rguisantos/pixgate/hardware/pixgate.kicad_pcb

## KiCad design hardware/pixgate.kicad_pcb (2026-11-12)

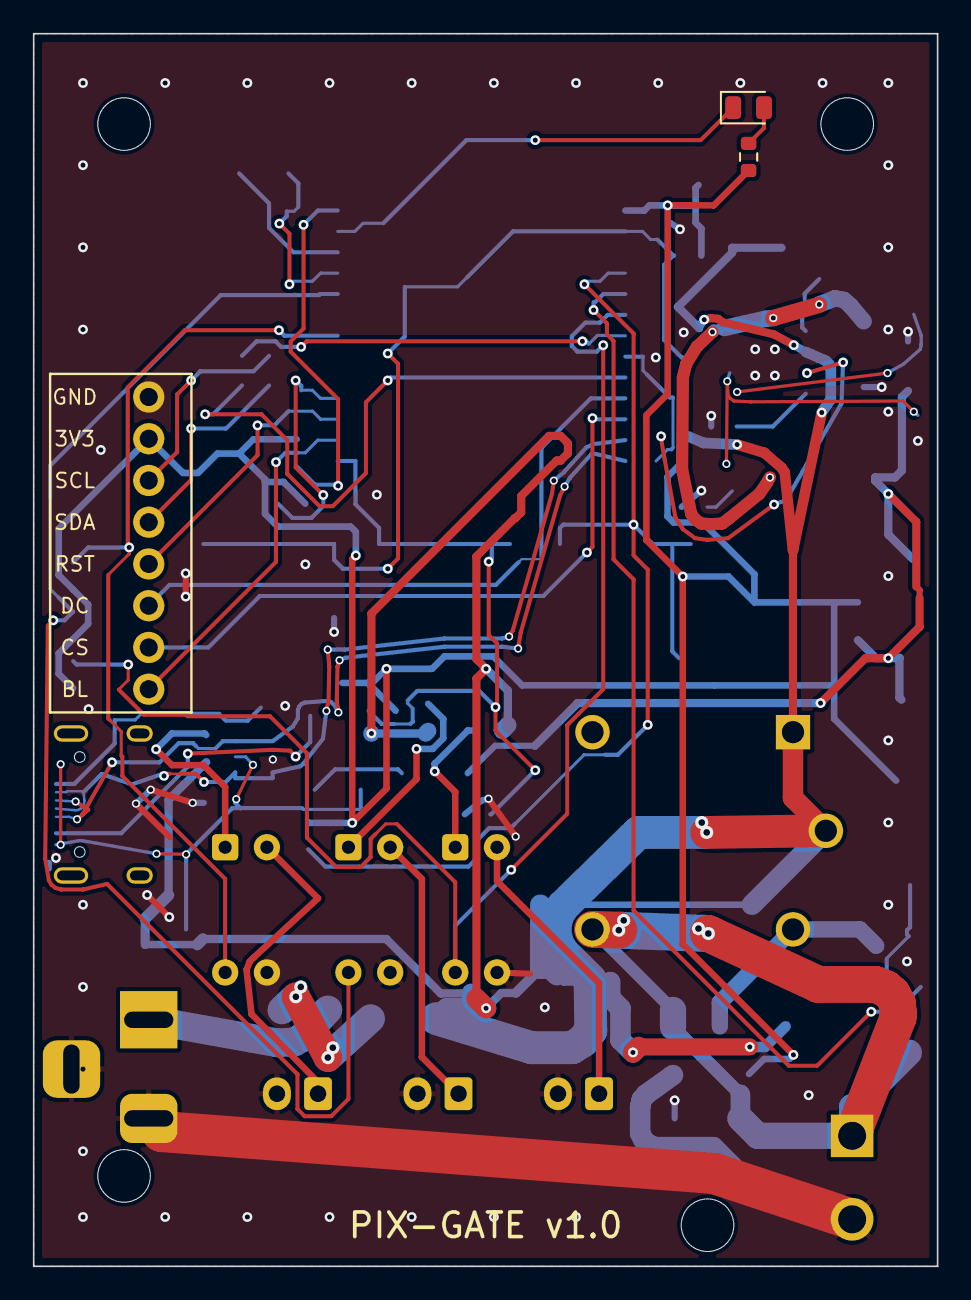
[picture p1: board pixgate.kicad_pcb from above]

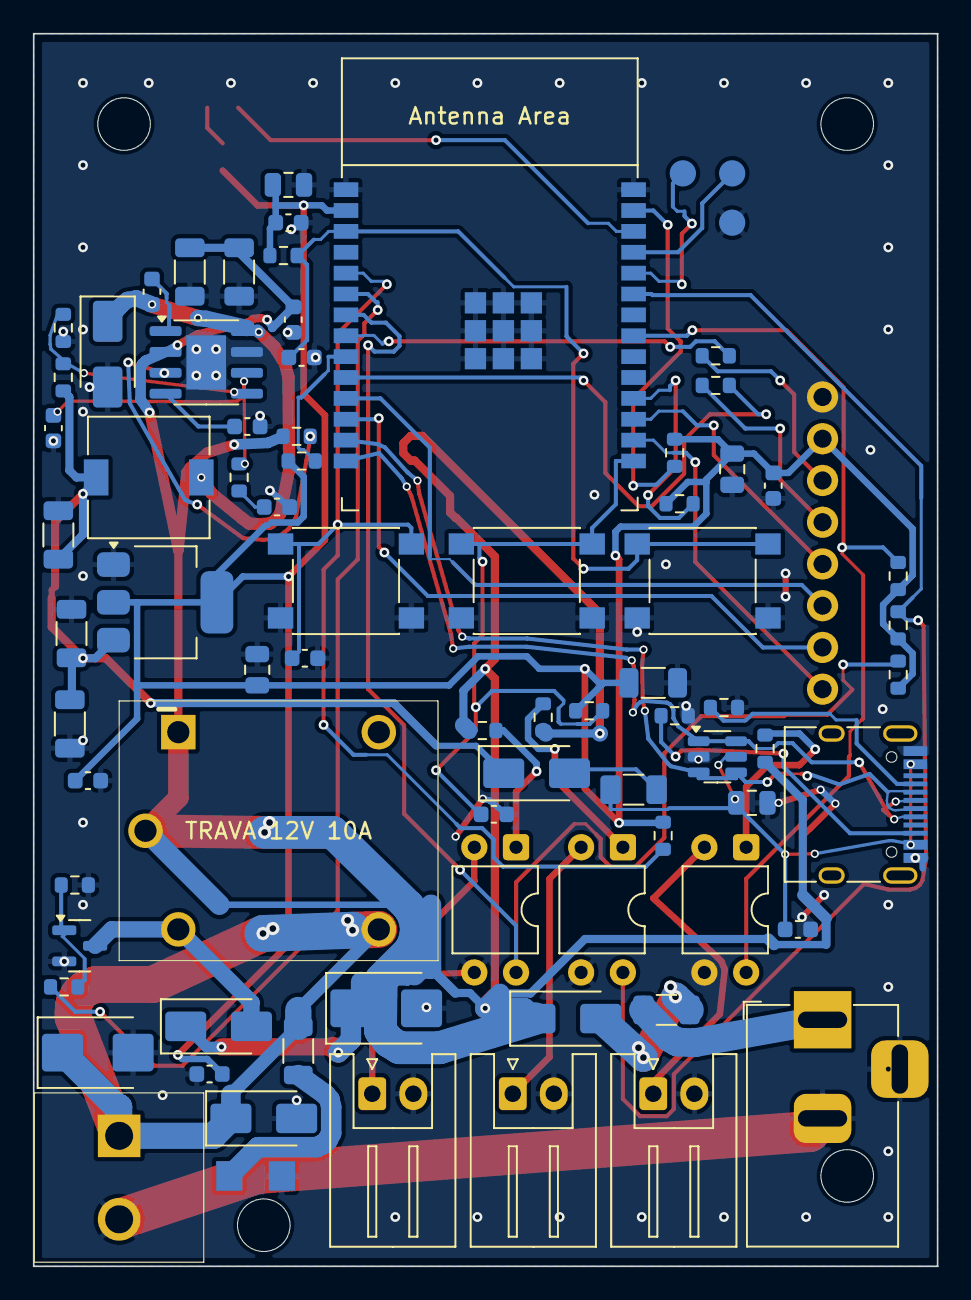
[picture p2: board pixgate.kicad_pcb from below]

Board: 2 copper layers, 55.0 x 75.0 mm, 85 parts (82 on the bottom side), 51 nets.

Parts:
C1, C2: 10uF/25V; C_1206_3216Metric
C3, C4, C9, C13, C15, C17, C19, C20, C21, C22: 100nF; C_0603_1608Metric
C5, C6: 33uF/10V; C_1206_3216Metric
C7: 4.7nF; C_0603_1608Metric
C8: 39pF; C_0603_1608Metric
C10, C12: 22uF; C_1206_3216Metric
C11, C14, C16, C18: 10uF; C_0805_2012Metric
C23: 1uF; C_0603_1608Metric
C24: 100nF; C_1206_3216Metric_NoSilk
D1, D5: SS54; D_SMA
D2, D3: SS14; D_SMA
D4: SMBJ18A; D_SMB
D6: SMBJ16A; D_SMB
D7: M7; D_SMA
F1, F2: 1206L050/24; Fuse_1206_3216Metric
H1, H2, H3, H4: M3; MountingHole_3.2mm_M3
J1: DC-005 12V; BarrelJack_Horizontal
J2: KF301 TRAVA; TerminalBlock_KF301-2P-5.08mm
J3: JST-XH NOTEIRO; JST_XH_S2B-XH-A_1x02_P2.50mm_Horizontal
J4: JST-XH MOEDEIRO; JST_XH_S2B-XH-A_1x02_P2.50mm_Horizontal
J5: JST-XH BOTAO; JST_XH_S2B-XH-A_1x02_P2.50mm_Horizontal
J6: USB-C; USB_C_Receptacle_HRO_TYPE-C-31-M-12
J7: TFT 1.54; DisplaySocket_1x08_P2.54mm
K1: SRD-12VDC-SL-C; Relay_SPDT_Songle_SRD
L1: 6.8uH; L_7.3x7.3_H3.5
LED1: STATUS; LED_0805_2012Metric
OPT1, OPT2, OPT3: PC817; DIP-4_W7.62mm
Q1: AO3400A; SOT-23
R1, R2: 5.1k; R_0603_1608Metric
R3: 100R; R_0603_1608Metric
R4, R7, R8, R9, R10, R11, R12, R13, R14, R15, R20: 10k; R_0603_1608Metric
R5, R6: 33R; R_0603_1608Metric
R16, R17, R18: 2.2k; R_0603_1608Metric
R19: 1k; R_0603_1608Metric
R21: 1.91k; R_0603_1608Metric
R22: 49.9k; R_0603_1608Metric
R23: 100R; R_1206_3216Metric
R26: 100k; R_0603_1608Metric
SW1: RST; SW_SPST_PTS645
SW2: BOOT; SW_SPST_PTS645
SW3: CFG; SW_SPST_PTS645
TP1: TX0; TestPad_TX0
TP2: RX0; TestPad_RX0
TP3: GND; TestPad_GND
U1: ESP32-C5-WROOM-1-N8; ESP32-C5-WROOM-1
U2: TPS54331DDA; SOIC-8-1EP_3.9x4.9mm_P1.27mm_EP2.41x3.3mm
U3: AMS1117-3.3; SOT-223-3_TabPin2
U4: USBLC6-2SC6; SOT-23-6

Connections:
+3V3: C11.2, C12.2, C13.1, C14.1, C15.1, C18.1, C19.1, C23.1, J7.2, R7.1, R8.1, R9.1, R10.1, R11.1, R12.1, R13.2, R14.2, R15.2, R19.1, U1.2, U3.2
+5V: C5.2, C6.2, C10.1, D2.1, L1.2, R20.2, U3.3
+12V: C1.1, C2.1, C3.1, D1.1, D3.1, D4.1, K1.A1, K1.COM, R16.2, R17.2, R18.2, R26.1, U2.2
+12V_IN: F1.1, J1.1
BOOT_C: C4.1, U2.1
BTN1: C21.1, R8.2, SW2.1, U1.15
BTN2: C22.1, R9.2, SW3.1, U1.5
BTN_A: OPT3.1, R18.1
BTN_SIG: J5.1, OPT3.2
CC1: J6.A5, R1.1
CC2: J6.B5, R2.1
COIN_A: OPT2.1, R17.1
COIN_SIG: J4.1, OPT2.2
COMP_X: C8.1, R22.1, U2.6
COMP_Y: C7.1, R22.2
DISP_BL: J7.8, U1.16
DISP_CS: J7.7, U1.12
DISP_DC: J7.6, U1.11
DISP_RST: J7.5, U1.17
EN: C20.1, R7.2, SW1.1, U1.3
EN_BK: R26.2, U2.3
F12V: D1.2, F1.2
FB: R20.1, R21.1, U2.5
GND: C1.2, C2.2, C3.2, C5.1, C6.1, C7.2, C8.2, C9.2, C10.2, C11.1, C12.1, C13.2, C14.2, C15.2, C16.2, C17.2, C18.2, C19.2, C20.2, C21.2, C22.2, C23.2, C24.2, D4.2, D5.2, D6.2, D7.2, J1.2, J1.3, J2.2, J3.2, J4.2, J5.2, J6.A1, J6.A12, J6.B1, J6.B12, J7.1, OPT1.3, OPT2.3, OPT3.3, Q1.2, R1.2, R2.2, R4.2, R21.2, SW1.2, SW2.2, SW3.2, TP3.1, U1.1, U1.28, U1.29, U2.7, U2.9, U3.1, U4.2
IN_BTN: OPT3.4, R15.1, U1.7
IN_COIN: OPT2.4, R14.1, U1.23
IN_NOTE: OPT1.4, R13.1, U1.21
IO7_PU: R10.2, U1.9
IO26_PU: R11.2, U1.27
IO27_PU: R12.2, U1.18
LED_A: LED1.2, R19.2
LED_K: LED1.1, U1.26
MOSI_D: J7.4, R6.1
MOSI_M: R6.2, U1.10
NOTE_A: OPT1.1, R16.1
NOTE_SIG: J3.1, OPT1.2
RELAY_COIL: D3.2, K1.A2, Q1.3
RLY_DRV: R3.1, U1.6
RLY_GATE: Q1.1, R3.2, R4.1
RX0: TP2.1, U1.24
SCK_D: J7.3, R5.1
SCK_M: R5.2, U1.8
SS_C: C9.1, U2.4
SW: C4.2, D5.1, L1.1, U2.8
TRAVA_NO: D6.1, D7.1, J2.1, K1.NO, R23.1
TRAVA_NO2: C24.1, R23.2
TX0: TP1.1, U1.25
USB_5V_F: D2.2, F2.2
USB_DN: J6.A7, J6.B7, U1.13, U4.3, U4.4
USB_DP: J6.A6, J6.B6, U1.14, U4.1, U4.6
USB_VBUS: C16.1, C17.1, F2.1, J6.A4, J6.A9, J6.B4, J6.B9, U4.5
