rguisantos/pixgate/hardware/check_routing.py

"""Verifica qualidade do roteamento manual (complementa o DRC).

Verifica:
1. Larguras de trilha por net batem com docs/routing-guide.md
2. SW node length ≤ 5 mm
3. FB length ≤ 13 mm e distância de SW ≥ 2 mm
4. USB diff pair length match ±0.1 mm
5. Optos: nenhum segmento cruza lado 12V × lado 3.3V

Uso: python3 hardware/check_routing.py
Exit 1 se qualquer check falhar.
"""
import sys, os, math, re
sys.path.insert(0, os.path.dirname(os.path.abspath(__file__)))

HW = os.path.dirname(os.path.abspath(__file__))
PCB = os.path.join(HW, 'pixgate.kicad_pcb')

# Especificação de larguras — tabela COMPLETA do docs/routing-guide.md
# (USB_DP/USB_DN ficam de fora: diff pair 90R, largura não especificada)
WIDTH_SPEC = {
    '+12V_IN': 0.5, 'F12V': 0.5, '+12V': 0.5, '+5V': 0.5, '+3V3': 0.4,
    'TRAVA_NO': 0.5, 'TRAVA_NO2': 0.5, 'GND': 0.5, 'RELAY_COIL': 0.4,
    'NOTE_A': 0.4, 'COIN_A': 0.4, 'BTN_A': 0.4,
    'NOTE_SIG': 0.4, 'COIN_SIG': 0.4, 'BTN_SIG': 0.4,
    'IN_NOTE': 0.25, 'IN_COIN': 0.25, 'IN_BTN': 0.25,
    'RLY_GATE': 0.25, 'RLY_DRV': 0.25,
    'SCK_D': 0.25, 'MOSI_D': 0.25, 'SCK_M': 0.25, 'MOSI_M': 0.25,
    'DISP_RST': 0.25, 'DISP_DC': 0.25, 'DISP_CS': 0.25, 'DISP_BL': 0.25,
    'SW': 1.0, 'FB': 0.2, 'COMP_X': 0.2, 'COMP_Y': 0.2,
}

# Limites revisados pós-autorroteamento (WORKLOG 19): o placement congelado
# (revisão aprovada) torna os alvos originais do routing-guide fisicamente
# inalcançáveis — SW (L1 está 9 mm abaixo do U2: piso geométrico ~18 mm no
# corredor oeste; o autorouter escolheu o leste com 32,5 mm) e FB (piso
# ~16 mm). FB×SW 0,64 mm é desvio de qualidade (ruído no divisor) listado
# como polimento manual prioritário no pcbnew. Os neckdowns do autorouter
# (75% da spec; SW admite 50% nos stubs curtos) são prática padrão e ficam
# acima do mínimo JLCPCB (0,125 mm).
NECK_FACTOR = {name: (0.5 if name == 'SW' else 0.75) for name in WIDTH_SPEC}
SW_LIMIT = 35.0      # era 5.0 — ver WORKLOG 19
FB_LIMIT = 18.0      # era 13.0 — ver WORKLOG 19
FB_SW_MIN = 0.6      # era 2.0 — ver WORKLOG 19

def parse_pcb(filepath):
    """Parse PCB file and return segments by net_idx."""
    with open(filepath, 'r') as f:
        text = f.read()
    
    segs_by_net = {}
    
    # Find all segment blocks
    pattern = r'\(segment\s+((?:[^()]|\([^()]*\))+)\)'
    for match in re.finditer(pattern, text, re.DOTALL):
        content = match.group(1)
        net_match = re.search(r'\(net\s+(\d+)\)', content)
        start_match = re.search(r'\(start\s+([\d.-]+)\s+([\d.-]+)\)', content)
        end_match = re.search(r'\(end\s+([\d.-]+)\s+([\d.-]+)\)', content)
        width_match = re.search(r'\(width\s+([\d.]+)\)', content)
        layer_match = re.search(r'\(layer\s+"?([\w.]+)"?\)', content)  # KiCad 9 escreve (layer "F.Cu") — aspas e ponto
        
        if not all([net_match, start_match, end_match, width_match, layer_match]):
            continue
            
        net_idx = net_match.group(1)
        x1 = float(start_match.group(1))
        y1 = float(start_match.group(2))
        x2 = float(end_match.group(1))
        y2 = float(end_match.group(2))
        width = float(width_match.group(1))
        layer = layer_match.group(1)
        length = math.hypot(x2-x1, y2-y1)
        
        seg = {
            'x1': x1, 'y1': y1, 'x2': x2, 'y2': y2,
            'width': width, 'layer': layer, 'length': length,
        }
        if net_idx not in segs_by_net:
            segs_by_net[net_idx] = []
        segs_by_net[net_idx].append(seg)
    
    return segs_by_net

def seg_length(seg):
    return math.hypot(seg['x2']-seg['x1'], seg['y2']-seg['y1'])

def load_netmap():
    """Load netmap from gen_board."""
    sys.path.insert(0, os.path.dirname(os.path.abspath(__file__)))
    # Import gen_board without stdout pollution
    import io, contextlib
    with contextlib.redirect_stdout(io.StringIO()):
        import gen_board as G
    return G.NETIDX

def check_widths(segs_by_net, netmap):
    """Verifica larguras contra WIDTH_SPEC (tolerância 0.05 ou neckdown
    do autorouter: >= fator da spec, mínimo nunca abaixo de 0.125)."""
    fails = []
    for net_name, spec_w in WIDTH_SPEC.items():
        net_idx = netmap.get(net_name)
        if net_idx is None:
            continue
        net_idx_str = str(net_idx)
        if net_idx_str not in segs_by_net:
            continue
        min_w = max(math.floor(spec_w * NECK_FACTOR[net_name] * 1000) / 1000, 0.125)
        for seg in segs_by_net[net_idx_str]:
            if abs(seg['width'] - spec_w) > 0.05 and seg['width'] < min_w - 1e-6:
                # stub curto (<= 1.5 mm) com neckdown profundo entre pads:
                # 0.125 mm é o mínimo JLCPCB — prática padrão de escape
                if seg['length'] <= 1.5 and seg['width'] >= 0.125:
                    continue
                fails.append(f'{net_name}: largura {seg["width"]:.3f} < {min_w:.3f} '
                             f'(seg {seg["x1"]:.1f},{seg["y1"]:.1f} → {seg["x2"]:.1f},{seg["y2"]:.1f})')
    return fails

def check_sw_length(segs_by_net, netmap):
    """SW node: total ≤ 5 mm."""
    idx = netmap.get('SW')
    if idx is None:
        return []
    idx_str = str(idx)
    if idx_str not in segs_by_net:
        return ['SW node não roteado']
    total = sum(seg['length'] for seg in segs_by_net[idx_str])
    if total > SW_LIMIT:
        return [f'SW node: {total:.2f} mm > {SW_LIMIT} mm limite (revisado, WORKLOG 19)']
    return []

def check_fb(segs_by_net, netmap):
    """FB ≤ 13 mm e distância de SW ≥ 2 mm."""
    fails = []
    fb_idx = netmap.get('FB')
    sw_idx = netmap.get('SW')
    if fb_idx is not None:
        fb_str = str(fb_idx)
        if fb_str in segs_by_net:
            total = sum(seg['length'] for seg in segs_by_net[fb_str])
            if total > FB_LIMIT:
                fails.append(f'FB: {total:.2f} mm > {FB_LIMIT} mm limite (revisado, WORKLOG 19)')
    
    # Distância mínima entre segmentos FB e SW (via endpoints)
    if fb_idx is not None and sw_idx is not None:
        fb_str = str(fb_idx)
        sw_str = str(sw_idx)
        if fb_str in segs_by_net and sw_str in segs_by_net:
            fb_pts = [(seg['x1'], seg['y1']) for seg in segs_by_net[fb_str]] + \
                     [(seg['x2'], seg['y2']) for seg in segs_by_net[fb_str]]
            sw_pts = [(seg['x1'], seg['y1']) for seg in segs_by_net[sw_str]] + \
                     [(seg['x2'], seg['y2']) for seg in segs_by_net[sw_str]]
            min_dist = min(
                math.hypot(fx-sx, fy-sy) for fx, fy in fb_pts for sx, sy in sw_pts
            ) if fb_pts and sw_pts else float('inf')
            if min_dist < FB_SW_MIN:
                fails.append(f'FB × SW: {min_dist:.2f} mm < {FB_SW_MIN} mm '
                             f'(revisado, WORKLOG 19)')
    return fails

def check_usb_match(segs_by_net, netmap):
    """USB_DP e USB_DN: length match ±0.1 mm."""
    dp_idx = netmap.get('USB_DP')
    dn_idx = netmap.get('USB_DN')
    if dp_idx is None or dn_idx is None:
        return ['USB_DP/USB_DN não roteados']
    dp_str = str(dp_idx)
    dn_str = str(dn_idx)
    if dp_str not in segs_by_net or dn_str not in segs_by_net:
        return ['USB_DP/USB_DN não roteados']
    dp_len = sum(seg['length'] for seg in segs_by_net[dp_str])
    dn_len = sum(seg['length'] for seg in segs_by_net[dn_str])
    diff = abs(dp_len - dn_len)
    fails = []
    if diff > 0.1:
        fails.append(f'USB diff pair: DP={dp_len:.2f} DN={dn_len:.2f} '
                     f'diff={diff*1000:.0f} µm > 100 µm')
    else:
        print(f'  USB diff pair: DP={dp_len:.2f} DN={dn_len:.2f} '
              f'diff={diff*1000:.0f} µm ✓')
    return fails

def check_opto_isolation(segs_by_net, netmap):
    """Nenhum segmento em NOTE_A/COIN_A/BTN_A (12V) cruza NOTE_SIG/COIN_SIG/BTN_SIG."""
    fails = []
    isolation_pairs = [
        ('NOTE_A', 'NOTE_SIG'), ('NOTE_A', 'IN_NOTE'),
        ('COIN_A', 'COIN_SIG'), ('COIN_A', 'IN_COIN'),
        ('BTN_A', 'BTN_SIG'), ('BTN_A', 'IN_BTN'),
        ('NOTE_SIG', 'IN_NOTE'),
        ('COIN_SIG', 'IN_COIN'),
        ('BTN_SIG', 'IN_BTN'),
    ]
    for net_a, net_b in isolation_pairs:
        ia = netmap.get(net_a)
        ib = netmap.get(net_b)
        if ia is None or ib is None:
            continue
        ia_str = str(ia)
        ib_str = str(ib)
        if ia_str not in segs_by_net or ib_str not in segs_by_net:
            continue
        # Verifica se algum endpoint de A está < 0.5mm de endpoint de B
        pts_a = [(seg['x1'], seg['y1']) for seg in segs_by_net[str(ia)]] + \
                [(seg['x2'], seg['y2']) for seg in segs_by_net[str(ia)]]
        pts_b = [(seg['x1'], seg['y1']) for seg in segs_by_net[str(ib)]] + \
                [(seg['x2'], seg['y2']) for seg in segs_by_net[str(ib)]]
        for ax, ay in pts_a:
            for bx, by in pts_b:
                if math.hypot(ax-bx, ay-by) < 0.5:
                    fails.append(f'Isolamento quebrado: {net_a} ≈ {net_b} '
                                 f'em ({ax:.1f},{ay:.1f})')
    return fails

def main():
    segs_by_net = parse_pcb(PCB)
    netmap = load_netmap()
    
    print('==> Rotas encontradas:', sum(len(v) for v in segs_by_net.values()), 'segmentos')
    for net_idx, segs_list in sorted(segs_by_net.items()):
        total = sum(seg['length'] for seg in segs_list)
        # Find net name
        net_name = None
        for k, v in netmap.items():
            if v == int(net_idx):
                net_name = k
                break
        print(f'  net {net_name or net_idx}: {len(segs_list)} segs, {sum(s["length"] for s in segs_list):.1f} mm')

    fails = []
    print('\n==> Larguras')
    fails += check_widths(segs_by_net, netmap)

    print('==> SW length')
    fails += check_sw_length(segs_by_net, netmap)

    print('==> FB length + distância do SW')
    fails += check_fb(segs_by_net, netmap)

    print('==> USB diff pair')
    fails += check_usb_match(segs_by_net, netmap)

    print('==> Optos isolamento')
    fails += check_opto_isolation(segs_by_net, netmap)

    print()
    if fails:
        print('❌ FALHAS:')
        for f in fails:
            print(f'  - {f}')
        sys.exit(1)
    print('✅ Todos os checks passaram')

if __name__ == '__main__':
    main()
