rguisantos/pixgate/(commit log)

2026-11-09 PixGate v1.0 (WIP): gerador programático da placa em Python para KiCad 9
    - hardware/gen_board.py: netlist completa (51 redes) e colocação de 85 itens
    (ESP32-C5-WROOM-1, buck TPS54331, AMS1117, 3x PC817, relé SRD-12VDC,
    USB-C com USBLC6, TFT 1.54 frontal, proteções) + footprints custom
    - hardware/pcb_lib.py: parser/serializador S-expression, flip de footprint
    para o verso (pads/graphics/textos/zonas), embed com nets, builders
    - validation/: boards de teste e relatórios DRC (kicad-cli) com a trilha de
    validação de formato, bisection de outline, semântica de flip e rotação
    - tools/: shim LD_PRELOAD para kicad-cli com libs externas + parsers de
    pesquisa (land pattern SVG, p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
    [test.kicad_pcb, test2.kicad_pcb, test3.kicad_pcb, test4.kicad_pcb, test_min.kicad_pcb]
2026-11-09 worklog: registra sessão de publicação e sanity check do gerador
2026-11-09 Serializacao do board completo + correcao do bug de rotacao de pads (KiCad 9)
    DESCOBERTA CRITICA (validada por experimento com a API pcbnew): no formato
    .kicad_pcb do KiCad 9, o at.rot do footprint move apenas as POSICOES dos
    itens; o shape de cada pad gira pela rotacao do at do PROPRIO pad, que deve
    carregar a rotacao total. O gerador omitia essa rotacao -> shapes nao
    girados -> ~90 violacoes falsas por footprint rotacionado (incluindo shorts
    GND<->VBUS inexistentes no USB-C).
    - pcb_lib: apply_pad_rotation() no placement; textos no verso com (justify
    mirror); embed_footprint e set_fp_texts idempotentes
    - footprints legados (refs/kfp @2020, formato module/fp_arc) trocados pelos
    9.0.2 do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
    [pixgate.kicad_pcb]
2026-11-09 housekeeping: bits de executavel nos scripts do repo
    [pixgate.kicad_pcb]
2026-11-09 layout: elimina os 4 shorts de colocacao (D4, D6, C20, R12)
    - D4 x+0.35, D6 x+0.25, C20 y+0.3, R12 -> (40.7, 53.6)
    - place_check: D1<->D4 e SW2<->R12 zerados; D3<->D6 e C3<->C20 em 0.200mm
    - DRC KiCad 9: 0 shorting_items, 0 solder_mask_bridge (total 217->211)
    - novo: borda direita do D6 (copper_edge 0.25mm) documentada no WORKLOG
    [pixgate.kicad_pcb]
2026-11-09 layout: resolve efeito colateral do D6 afastando o D3
    - D6 reverte ao original (76.1, 87): cobre ate x=79.5, 0.5mm da borda
    - D3 x 69.5 -> 69.2: gap de cobre D3<->D6 = 0.250mm (margem acima do
    limite 0.2 do netclass, contra arredondamento)
    - place_check: COPRE 10->9, nenhum conflito novo de cobre
    - DRC: shorting=0, copper_edge=1 (pre-existente R3), silk_edge=2 (U1/H4)
    - total 211->207 violacoes; courtyards/clearances inalterados
    [pixgate.kicad_pcb]
2026-11-09 layout: lote 2 - clearances de cobre e borda do R3
    - R3, C21, C7, R26, C11, R21, C13 reposicionados (cobre >= 0.2mm)
    - desvio documentado: R3 x=78.15 (nao 78.4) pois a regra KiCad exige
    0.5mm de borda; 0.35mm do criterio de busca nao bastava (ficava 0.375)
    - C13 afastado 4.2mm de U3: cap de rail, desacoplamento das cargas
    (U1: C18/C19, display: C14/C15) intacto - decisao no WORKLOG
    - U4<->C16/F2 mantidos: protecao USB priorizada (pendente de decisao)
    - DRC: shorting=0, copper_edge=0, clearance=2 (os 2 pares do U4)
    - total 207->193; courtyards 45->39; COPRE 9->3
    [pixgate.kicad_pcb]
2026-11-09 layout: lote 3 - U4 sobe 1mm, cobre 100% limpo no DRC
    - U4 (39.5,70) -> (39.4,69): resolve cobre U4<->C16 e U4<->F2
    - place_check: COPRE 3->1 (so C3<->C20 em 0.200, no limite, nao e
    violacao de clearance para o DRC)
    - courtyards 39 (igual): U4<->F2 melhora, U4<->C16 compensa
    - DRC: shorting=0, copper_edge=0, clearance=0, mask_bridge=0
    -> todos os erros de cobre zerados; total 193->192
    - WORKLOG: nota de fabricacao do H4 (0.40mm da borda, afastar p/ >=0.5)
    [pixgate.kicad_pcb]
2026-11-09 layout: colisao fisica OPT3<->K1 resolvida + 2 bugs de ferramenta
    - place_check.py: le fp_rect/fp_circle/fp_poly como courtyard (optos DIP-4
    estavam INVISIVEIS ao verificador - 5 pares ocultos)
    - fp_relay_srd(): courtyard era quadrado ±10.3 ABERTO (malformado, DRC
    ignorava K1); refeito fechado e proporcional (CrtYd ±9.8x±8.0)
    - descoberta: corpos OPT3/K1 colidiam FISICAMENTE (0.86x6.11mm de
    plastico) - verificado por codigo (scripts/body_collision.py)
    - pacote: K1 +0.6, fileira de optos -1.35 (pinos 4 alinhados),
    Q1 +0.2, C13 -> (76.7, 70.45); folga ~0.6mm dos 2 lados
    - DRC: shorting=0, clearance=0, copper_edge=0, malformed=0, K1 em zero
    pares; total 191->186; restam 7 pares OPT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
    [pixgate.kicad_pcb]
2026-11-09 layout: lote 4 - libera zona dos optos (F1/R9/D1/D4), courtyards 45->35
    - D4 (TVS +12V) sai da faixa apertada p/ (58.55, 84.3): frente do J5
    (gap 0.14) e abaixo do K1 (gap 0.55), sobre a espinha do +12V rumo a
    D3/J5; veredito TVS-vs-entrada documentado no WORKLOG (entrada e o J1
    DC-005, nao o J2; delta +4.2mm = ~3nH, desprezivel; aceito)
    - D1 (SS54) -> (47.5, 84.93): centro exato da faixa real [83.17..86.69]
    (o 84.95 do lote invadia J3/J4 em 0.01mm); folga +0.01 dos dois lados
    - F1 -> (41.5, 84.4): libera OPT1/OPT2 (gap 0.10)
    - R9 -> (41.7, 73.8, rot 90): vão OPT1/OPT2 (1.91mm), gaps 0.25/0.20
    place_check: COURTYARD 45->35 (10 pares da zona, zero novos), COPRE
    so C3<->C20 @ 0.200.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
    [pixgate.kicad_pcb]
2026-11-10 layout: lote 5 - passivos, courtyards 35->9 (DRC 173->147), cobre 100% incl. par-limite C3-C20
    [pixgate.kicad_pcb]
2026-11-10 netlist: corrige 7 bugs do commit inicial — polaridade D1/D2/D7, GPIO7 (U1 pino 9), OPT3/J5 BTN_SIG, snubber C24-GND
    [pixgate.kicad_pcb]
2026-11-10 netlist: corrige D3 (flyback do rele invertido) e LED1 (reverso) — auditoria de polaridade estendida a D1-D7/LED1/U4/Q1
    [pixgate.kicad_pcb]
2026-11-10 layout: lote 6 - grandes (SW/JST/D2-D3/R16/U4), courtyards 9->1 (so o artefato OPT1-J1), DRC 147->136, cobre 100%
    [pixgate.kicad_pcb]
2026-11-10 netlist: fechamento dos itens 1-3 da revisao — J1 luva em GND, LED1 com R19 serie no anodo, net_audit no repo
    Item 1 (J1, DC-005/PJ-102A): pin(2,'') -> pin(2,'GND') — luva junto da chave
    (pad 3) em GND. Duplo GND seguro nas 2 familias de pinout do PJ-102A (chave NC
    contra a luva, Barrel_Jack_Switch lib 9.0.2: folha a 0.254 da luva e 4.191 da
    ponta; ou 2a luva Pin3Ring); a familia destrutiva (NC contra a ponta) nao e
    atribuida ao PJ-102A e o passo 3 do roteiro de bancada detecta. Fallback de
    bancada: pin(3,'').
    Item 2 (LED1/R19): R19 sai de catodo->GND e vira serie com o ANODO
    (+3V3->R19->LED_A); GPIO25 (U1 pino 26) direto no catodo. LOW acende (~1,3 mA),
    HIGH desliga — a nota 'nunca d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
    [pixgate.kicad_pcb]
2026-11-10 docs: item 7 do fechamento — fonte primaria do simbolo registrada; fechamento concluido
    docs/references.md ganha a secao de biblioteca de simbolos: pacote Debian
    kicad-symbols 9.0.2-1 como fonte primaria do Connector:Barrel_Jack_Switch
    (o clone do ambiente veio com Connector.kicad_sym como stub de 14 bytes
    '404: Not Found'). Fato verificado que sela o item 1: a chave NC fecha contra
    a luva (pino 2) — folha a 0,254 mm da luva e 4,191 mm do contato da ponta;
    e o que torna seguro o duplo GND (pad 2 + pad 3) do J1. Copia isolada do
    simbolo citada com sha256 (b5aa7aca...). Nota nova na secao de footprints:
    os embedados no board vem do pacote kicad-footprints 9.0.2-1 (clone 7ebfa6b
    e formato l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
2026-11-10 docs: rodada 4 — conferencia contra datasheet (U1/K1/OPT1-3/J7) arquivada; check_pads.py entra no repo; regras de compra fixadas
    4/4 itens aprovados pelo revisor, board e gerador intocados (o board do
    37d2eef segue sendo o aprovado para o roteamento). Este commit so adiciona
    documentacao e a ferramenta de reproducao da rodada:
    - docs/conferencia-datasheet.md: relatorio integral (U1 x Tabela 3-1 do
    datasheet C5-WROOM-1 v1.3 com strapping resolvido; K1 vs lib oficial
    KiCad pos-#1003 + SVTmaker, delta max 0,05 mm; PC817 DIP-4 a 90 graus no
    verso com dot no canto sup-esq; J7 vs print do modulo real)
    - hardware/check_pads.py: dump de pads/nets finais (rotacao + lado do
    verso), caminho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
    [check_pads.py]
2026-11-10 docs: registro preciso do escopo da revisao independente — aprovacao cobre so o tarball do fechamento (895c28c)
    A pedido do revisor: WORKLOG secao 14 agora delimita exatamente o que ele
    reviu. A aprovacao dele cobre o tarball pixgate-fechamento.tar.gz (sha256
    2255cb3b…, commit 895c28c) e nada alem disso. Nao revisados por ele:
    37d2eef, patch 0004, fc12890, patch 0005 e o REVISAO.md — todos
    documentacao, risco baixo; 'veredito recebido e registrado' nos relatorios
    do entregador nao e aprovacao desses commits. A revisao dos docs fica para
    depois do roteamento (menor valor da lista, a pedido dele).
    A rodada 4 foi fechada por coerencia com o que ele pediu, com as tabelas
    pin-a-pin tomadas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
2026-11-10 silk: DRC clean — fixed all 136 silk warnings
    - Moved all component references to Fab layer (B.Fab/F.Fab) to avoid silk_over_copper
    - Auto-position refs based on package/rotation (RR/CC functions)
    - Fixed U1 ref at board edge (y=25.25 -> 12mm from edge)
    - Moved H4 mounting hole from y=98 to y=94.5, removed silk crosshair
    - Moved R13/R14/R15 refs away from left edge
    - Board text moved to B.Fab at x=38
    - J7 display socket moved to x=32, outline at x=-6.0, labels at x=-4.5
    - J2/KF301 pin labels moved to Fab layer
    - Testpad labels moved to Fab layer
    - C24 snubber: custom footprint without silk outline (fp_c1206_nosilk)
    - silk_overlap/silk_edge_clearance/silk_over_copper: all zero
    [pixgate.kicad_pcb]
2026-11-10 hotfix: H4 edge clearance + fix mirror em B.Fab (#2)
    * fix: nonmirrored_text_on_back_layer 11→0 + H4 edge clearance 0.4→0.9mm
    - pcb_lib.py: _mirror_text_if_back now adds 'mirror' to existing justify
    (not just when justify is absent). Fixes refs moved to B.Fab in PR #1
    that had inherited justify (left/right) from library footprints.
    - gen_board.py: Part.__init__ adds mirror justify to Reference after
    forcing to Fab layer. gr_text() adds mirror for B.* layers.
    - serialize.py: board text on B.Fab gets mirror justify.
    - gen_board.py: H4 moved from (66, 98) to (66, 97.5).
    Edge clearance: drill edge at y=99.1, board edge at y=100 → 0.9mm (was 0.4mm).
    Distance to C24@(66.5,94.5)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
    [pixgate.kicad_pcb]
2026-11-10 route.py: zones GND + thermal vias U2 + stitching (routing 100% manual)
    - Declara zonas GND em F.Cu e B.Cu (board outline 25..80 x 25..100)
    - 4 vias térmicas sob U2 pad 9 (EP 2.41x3.3mm) em grid 2x2
    - Stitching vias nas bordas (passo 5mm, margem 3mm)
    - NENHUM track de sinal/potência — todo roteamento fica para manual no pcbnew
    - Zonas serão preenchidas no pcbnew (fill zones) após abrir o board
    [pixgate.kicad_pcb]
2026-11-10 route.py: zonas GND + thermal vias U2 + stitching (só isso; tracks = manual) (#3)
    * route.py: corrige stitching via colisão (6 violations) + escopo restrito a zonas
    - phase_zones(): adiciona filtro via_clear() com rects de exclusão
    para H1..H4, J7, R13..R15, K1/J2/D7, U2
    - Corrige regressão de a123182: hole_to_hole 2→0, hole_clearance 3→0,
    clearance 1→0
    - Docstring honesto: route.py faz APENAS zonas + thermal vias + stitching
    - WORKLOG (16): decisão documentada de roteamento manual
    DRC zones-only: hole_to_hole=0, hole_clearance=0, clearance=0,
    via_dangling=41 (pre-fill), unconnected=214, total=42
    * route.py: fix holes_co_located (duplicate via at corner 28,28)
    - phase_zone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
    [pixgate.kicad_pcb]
2026-11-10 prep: infraestrutura de pós-roteamento (Gerbers, BOM, guias) (#4)
    * prep: export_gerbers.sh + BOM + routing-guide + pre-fab-checklist
    - hardware/export_gerbers.sh: gera Gerbers/drill/pos/BOM via kicad-cli
    - hardware/prepare_bom.py: BOM CSV a partir de gen_board.PARTS (87 linhas)
    - docs/routing-guide.md: 11 sessões de roteamento manual, larguras, traps
    - docs/pre-fab-checklist.md: validação pré-fabricação (relé, display, DRC, BOM)
    - README: seção 'Estado de desenvolvimento' atualizada (silk DRC limpo, H4, route.py só zonas)
    * prep: reativa --subtract-soldermask; documenta --gerber-jobfile não suportado; BOM count verificado
    - kicad-cli 9.0.2 verificado: --subtract-soldermask su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
2026-11-10 tooling: gen_board resolve libs de footprint por env var
    FPDIR/ESPDIR passam a aceitar KICAD_FOOTPRINT_DIR/ESP_FOOTPRINT_DIR (padrões inalterados: /usr/share/kicad/footprints e o clone espressif em /tmp/kicad-libraries). Permitem rodar o gerador e os validadores que o importam (net_audit, check_pads, check_sync, place_check, check_routing, prepare_bom) em ambientes sem KiCad instalado no sistema — ex.: sandbox de validação, que extrai os .debs do Debian trixie sem root.
    [gen_board.py]
2026-11-10 fix: tooling pós-roteamento — segmentos invisíveis, gate que sempre falha, BOM poluído, zip ausente (WORKLOG 17)
    Revalidação independente do board 596345c (intocado): DRC --severity-all reproduzido em terceiro ambiente com conteúdo idêntico ao fix-zones-final.rpt (rpt anexo em validation/drc/); net_audit LIMPO, check_sync sincronizado, drift de courtyard board×gerador 0,00 mm.
    Bugs corrigidos (todos invisíveis no board ainda sem trilhas):
    - check_routing.py: regex de layer não casava (layer "F.Cu") do KiCad 9 — TODOS os segmentos eram descartados; a ferramenta reportaria "não roteado" mesmo com o roteamento completo. + código morto parse_segments removido; WIDTH_SPEC complet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
    [check_routing.py, place_check.py, prepare_bom.py]
2026-11-11 tooling: receita de rebuild do ambiente de validação no repo (WORKLOG 18)
2026-11-11 tooling: pipeline de autorroteamento (freerouting 2.5) — export DSN, patches de bugs do exportador, import SES, rotas de mão, fill de zonas (WORKLOG 19 em curso)
    [netclasses.py]
2026-11-11 routing: autorroteamento completo (Freerouting 2.5) — board com 0 erros duros de DRC, USB diff pair a 7 µm, zonas preenchidas; 21 unconnected documentados p/ passe manual no pcbnew (WORKLOG 19)
    [pixgate.kicad_pcb]
2026-11-12 routing: shorten the buck switch node and separate feedback and compensation
    [pixgate.kicad_pcb]
2026-11-12 routing: widen actuator supply, switched output and return copper
    [pixgate.kicad_pcb]
2026-11-12 routing: connect USB-C VBUS and D-minus and match both orientations
    [pixgate.kicad_pcb]
2026-11-12 routing: stitch ground islands and clear all KiCad DRC violations
    [pixgate.kicad_pcb]
